dpositive/Espresso-PID-Controller/(commit log)

2020-02-27 Create controller-max6675.ino.ino
    Chаnged sketch to work with max6675 therm controller
2020-03-01 resistive keypad support implemented
